vulcu/opossum/docs/images/Board-to-Board_Wiring.jpg

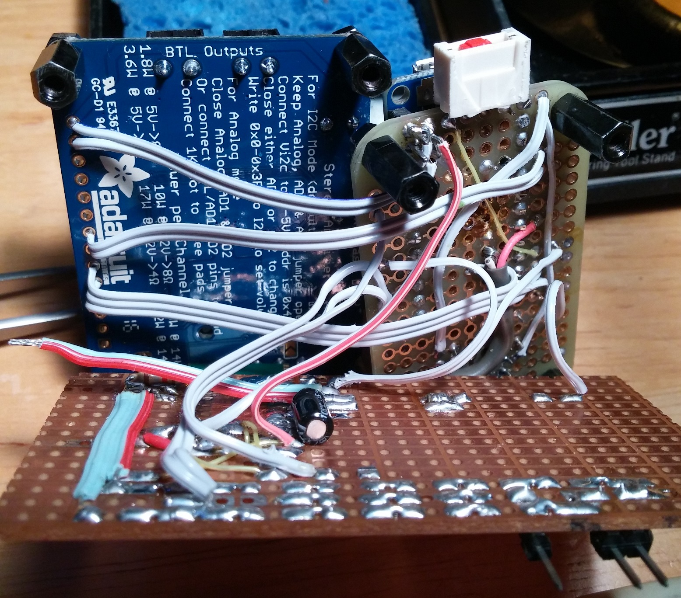
docs/images/Board-to-Board_Wiring.jpg
