vulcu/opossum/docs/images/Opossum_Bluetooth_Amplifier.jpeg

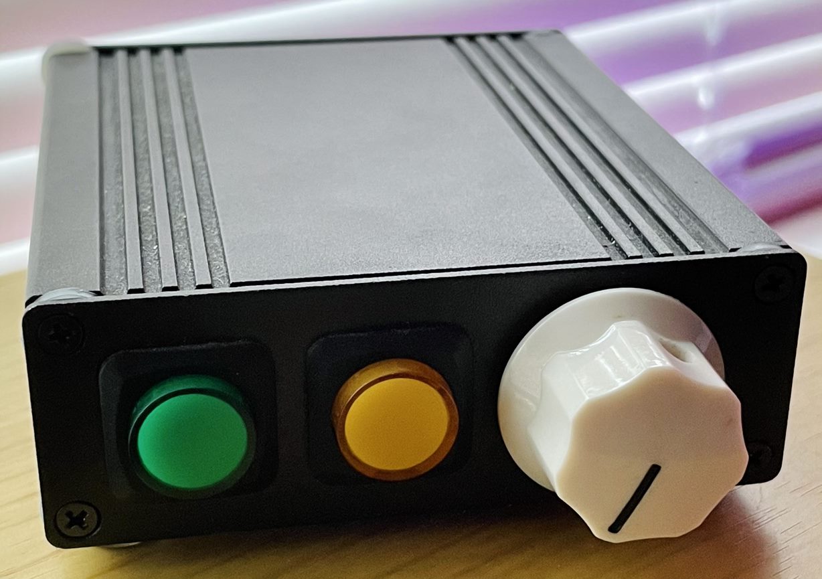
docs/images/Opossum_Bluetooth_Amplifier.jpeg
