vulcu/opossum/docs/schematics/Opossum_Bluetooth_Amplifier_(RevA5).pdf

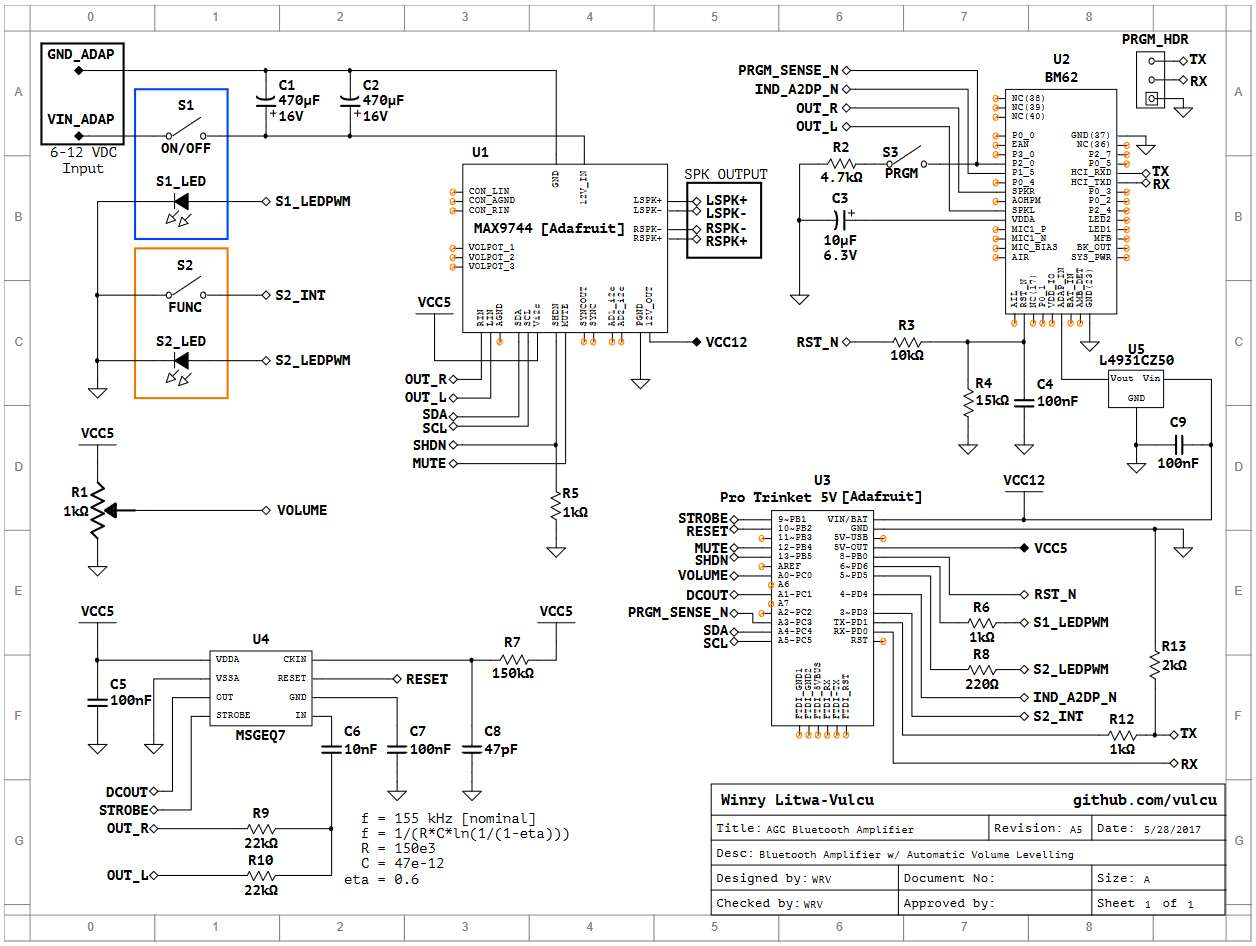
[picture p3: page 1]
