vulcu/opossum/docs/images/BM62_and_L4931CZ50.jpg

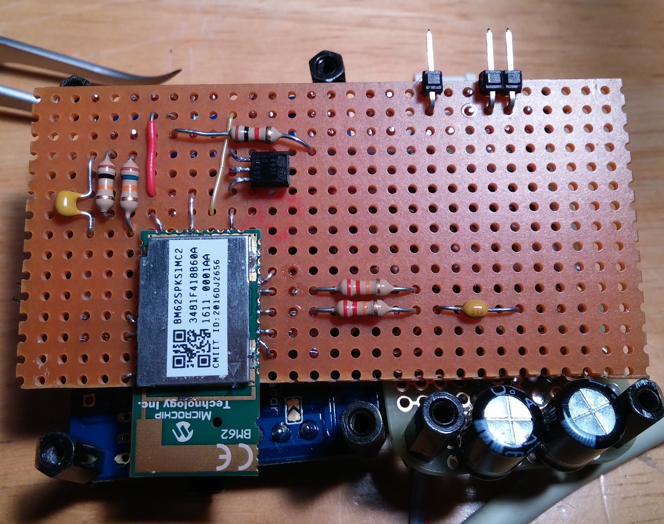
docs/images/BM62_and_L4931CZ50.jpg
