vulcu/opossum/docs/images/Pro_Trinket_MSGEQ7_and_MAX9744.jpg

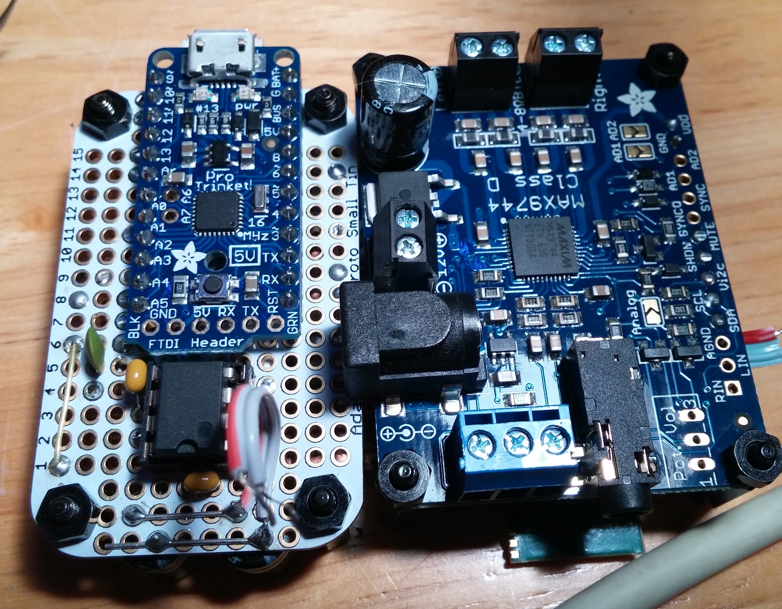
docs/images/Pro_Trinket_MSGEQ7_and_MAX9744.jpg
