vulcu/opossum/opossum/MAX9744.cpp

/*
 * MAX9744.cpp - Maxim MAX9744 Class-D Amplifier driver for Arduino
 * Copyright (c) 2017 Winry R. Litwa-Vulcu. All rights reserved.
 *
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
 * You should have received a copy of the GNU General Public License
 * along with this program.  If not, see <https://www.gnu.org/licenses/>.
 */

#include "MAX9744.h"

// MAX9744 amplifier gain levels (dB), stored as milli-Bells 
// (1/100 of a dB) to allow PROGMEM storage as an int type
const int16_t MAX9744::MAX9744Gain_milliBels[64] PROGMEM = 
{
  -10950,  -9290,   -9030,   -8680,
  -8430,   -8080,   -7830,   -7470,
  -7220,   -6870,   -6620,   -6270,
  -6020,   -5670,   -5420,   -5060,
  -4810,   -4560,   -4370,   -4210,
  -3960,   -3760,   -3600,   -3340,
  -3150,   -2980,   -2720,   -2520,
  -2350,   -2160,   -1970,   -1750,
  -1640,   -1540,   -1440,   -1310,
  -1200,   -1090,   -990,    -890,
  -710,    -600,    -500,    -340,
  -190,    -50,      50,      120,
   160,     200,     240,     290,
   340,     390,     440,     490,
   540,     590,     650,     700,
   760,     820,     880,     950
};

// class constructor for MAX9744 amplifier object
MAX9744::MAX9744(uint8_t i2c_addr, uint8_t mute_p, uint8_t shutdown_n, TwoWire* wire) :
  invert_mute(false) {
  this->i2c_addr = i2c_addr;
  this->mute_p = mute_p;
  this->shutdown_n = shutdown_n;
  this->wire = wire;
}

// initialize the MAX9744 and GPIO signals
void MAX9744::init(void) {
  pinMode(mute_p, OUTPUT);
  pinMode(shutdown_n, OUTPUT);

  // mute the MAX9744 then take it out of shutdown
  mute();
  enable();
}

// enable the MAX9744 by taking it out of shutdown (HIGH)
void MAX9744::enable(void) {
  digitalWrite(shutdown_n, HIGH);
}

// invert the mute signal (needed for use with Adafruit MAX9744 board)
void MAX9744::invertMuteLogic(const bool invert_mute) {
  this->invert_mute = invert_mute;
}

// mute the MAX9744 amplifier via the MUTE pin
void MAX9744::mute(void) {
  // if the mute signal is inverted then set LOW to mute
  if (invert_mute) {
    digitalWrite(mute_p, LOW);
  }
  else {
    digitalWrite(mute_p, HIGH);
  }
}

// disable the MAX9744 via the GPIO shutdown signal
void MAX9744::shutdown(void) {
  digitalWrite(shutdown_n, LOW);
}

// unmute the MAX9744 amplifier via the MUTE pin
void MAX9744::unmute(void) {
  // if the mute signal is inverted then set HIGH to unmute
  if (invert_mute) {
    digitalWrite(mute_p, HIGH);
  }
  else {
    digitalWrite(mute_p, LOW);
  }
}

// set the amplifier volume to a value between 0 [min] and 63 [max]
void MAX9744::volume(const uint8_t value) {
  // if the value is less than 64 and two-wire is configured
  if ((value < 64) & (TWCR != 0x00)) {
    wire->beginTransmission(i2c_addr);
      wire->write(value);
    wire->endTransmission();
  }
}

// return the dB gain values correllating amplifier volume settings
inline int16_t MAX9744::getGainAtVolumeIndex(const uint8_t index) {
  return pgm_read_word(&(MAX9744Gain_milliBels[index]));
}
