vulcu/opossum/(commit log)

2021-03-19 Update parameters.h
    added SERIAL_BUFFER_SIZE and ERROR_MSG_BUFFER_SIZE in the event that 'error.h' does get utilized
    [parameters.h]
2021-03-19 Update Opossum.ino
    moved MAX9744GainLevels init to 'drivers.h'
2021-03-19 Update Opossum.ino
    moved BM62 UART inits to 'drivers.h'
2021-03-19 Update Opossum.ino
    moved LED brightness values over to 'parameters.h'
2021-03-19 Update Opossum.ino
    moved BM62_isProgramMode def over to 'drivers.h'
2021-03-19 Update Opossum.ino
    moved `MSGEQ7_read` and `MSGEQ7_mean` definitions over to 'drivers.h'
2021-03-19 Update Opossum.ino
    serial debug console now outputs `volumeRange` at index 2 and 3 of Serial.print output array
2021-03-19 Update Opossum.ino
    moved `BM62_checksum` definition over to 'drivers.h'
2021-03-19 moved code from main *.ino file to header files for better code legibility and easier maintenance
    a lot of hardware control and I/O related function definitions and constants were moved over to 'drivers.h' and 'parameters.h'
2021-03-20 Create BM62 driver class
    refactor BM62 driver code from 'driver.h' to a separate class defined in 'BM62.h'
2021-03-20 remove old driver code
    comment out old BM62 driver code and configure to use new BM62 driver only
2021-03-20 Update BM62.h
    fix media play control input arguments from `uint8_t` for `void`
    [BM62.h]
2021-03-20 refactor UART write process to remove redundant code
2021-03-20 remove old BM62 driver from 'drivers.h'
2021-03-20 update BM62 driver
    * removed `low`, `high`, and `read` methods
    * instances of `low` and `high` replaced with built-in digitalWrite
    * added `isConnected` method to return active A2DP connection state (`false` if no connection available)
    * added `reset` method to set active state of `RST_N` reset pin (setting this `true` will put the BM62 into reset)
    [BM62.h, Opossum.ino]
2021-03-20 update main code to use to new 'MSGEQ7.h' driver
2021-03-20 comment out old driver
2021-03-21 remove old commented driver code
2021-03-21 change BM62 reset method from `reset(true/false)` to `enable()/reset()`
    [BM62.h]
2021-03-21 Update BM62.h
    fix typo when calling isConnected()
    [BM62.h]
2021-03-21 create 'MAX9744.h', delete 'drivers.h'
    initial commit of MAX9744 driver, nonfunctional but not removing any functionality either. Copied directly from 'drivers.h'.
2021-03-21 removed reference to deleted 'drivers.h' header in main file
2021-03-21 modify BM62 and MSGEQ7
    * Drivers now require pin numbers on init instead of using 'parameters.h' macros. Simplifies the way HW definitions are provided to the driver and greatly improves portability of code
    * restructured driver classes to put public methods first, followed by private methods
2021-03-21 fix enable()/reset() logic inversion in BM62 driver
    [BM62.h]
2021-03-21 Update Opossum.ino
    remove 'drivers.h' include
2021-03-22 update driver define name to better match other code I've seen? don't know what's good practice here
2021-03-22 added in probably all the methods needed, although driver not presently working
2021-03-22 Update MSGEQ7.h
    modified `strobe` and `reset` to `strobe_p` and `reset_p`
    [MSGEQ7.h]
2021-03-22 Update MAX9744.h
    fixed mute/shutdown control issues; driver is now working although there is some loud RF noise at startup not previously present
    [MAX9744.h]
2021-03-23 Fixed power-on noise (previous commit) and PROGMEM directive being ignored for gain table
    moved PROGMEM declaration of MAX9744 gain table outside of class as PROGMEM directive was being ignored. Might not be possible to use this macro from within a class?
    [MAX9744.h]
2021-03-23 Update Opossum.ino
    `OUTPUT` macro mistakenly used in place of `DC_OUT`
    [Opossum.ino]
2021-03-24 pass a pointer to drivers for TwoWire and HardwareSerial classes instead of driver instancing the hardware
2021-03-26 rename 'pushbutton.h' to 'ledbutton.h'
    and as LED as a class callable by BUTTON
2021-03-27 create LED and BUTTON classes, extend BUTTON class using LEDBUTTON
    * renamed 'ledbutton.h' to 'userinterface.h'
    * modified `S2_PWM` and `S1_PWM` type from `uint8_t` to `int8_t`
2021-03-27 start implementing SW2 interrupt service routing and button functionality
2021-03-27 completed rough framework of S2 interrupt routine
    not working yet :-1:
    [Opossum.ino, parameters.h]
2021-03-28 change SW2 to `inputPullup` and rename `buttonPressCount` to `buttonStateCount`
2021-03-28 fixed LED dereferencing bug in 'userinterface.h'
    [Opossum.ino, parameters.h]
2021-03-28 SW2 interrupts finally working... sort of :grimacing:
2021-03-29 add LED init to LEDBUTTON init, define S2 interrupt vector in 'parameters.h'
2021-03-29 Update userinterface.h
    override LEDBUTTON `enableInputPullup()` and `disableInputPullup()` methods to also initialize the LED
2021-04-03 modified `Button` and `LED_Button` class name capitalization (no longer all-caps)
    [Opossum.ino]
2021-04-03 Update Opossum.ino
    update main file to include latest changes to button interrupt handling
2021-04-03 ditched Timer1, button interrupts finally working as intended
2021-04-03 Update Opossum.ino
    brought debug build changes over, S2 button is working as expected
2021-04-10 use defined reset cycle wait time instead of a hardcoded value
    [BM62.h]
2021-04-10 add additional BM62 UART commands for EQ, pairing, and information
2021-04-10 split 'userinterface.h' out into 'ledbutton.h' and 'ledbutton.cpp'
2021-04-10 modify `#include` statements to reflect renaming from 'userinterface' to 'ledbutton'
2021-04-10 remove unused variable and define MSGEQ7 read pin input pullup in 'opossum.h'
2021-04-10 modified 'ledbutton.h' comments for clarity
2021-04-10 Update ledbutton.cpp
    fixed comment to correctly describe function
    [ledbutton.cpp]
2021-04-11 replace `BM62::writeMediaCommand` with `BM62::writeSerialCommand`
    [BM62.cpp, BM62.h]
2021-04-11 Update BM62.cpp
    comment out `GetDeviceInformation` and `GetElementAttributes` command data as these won't be implemented right now, but leave the comments because I don't want to lose this information later
    [BM62.cpp]
2021-04-11 fix spurious button trigger at power-on
    also fix missing call to `Audiomath` static method
    [Opossum.ino]
2021-04-17 modify BM62 driver to better conceptualize serial commands
    updating the driver in this way allows for an easier time adding new commands and also meshes much better with the way the datasheet/part documentation conceptualizes the serial uart commands
2021-04-17 fix 'not writing entire serial command' bug
    [BM62.cpp]
2021-04-17 update main file to start adding in button press functionality
    * added 'enter pairing mode' and 'enable/disable EQ' for now because those are the easiest ones
    * added some debug code around this but like the other `DEBUG` code blocks it's inside preprocessor directives
2021-04-17 fix 'led not initialized correctly during BT pairing'
    also added slight clarification to comment about delay to avoid missing UART reads b/c although it helps it's not guaranteed to work. this may be a bug or it may be a "won't fix" kind of bug
    [Opossum.ino]
2021-04-18 add features to BM62 driver
    * add play/pause media playback toggle function (pauses if playing, plays if paused)
    * added additional EQ presets to `setEqualizerPreset` method and `EQ_preset` enum
    * upgraded `...Next_Track` and `...Prev_Track` commands from deprecated syntax (formerly MMI actions, now Music Control actions)
2021-04-18 remove debug preprocessor directive for tracking button presses
2021-04-18 remove remaining debug button tracking code
2021-04-18 improve clarity of BM62 driver debug output
2021-04-19 add `convertVolumeToGain` method and store gain values in milli-Bels instead of centi-Bels
2021-04-20 add `convertVolumeToGain` method to MAX9744 driver
    * change MAX9744 gain level PROGMEM storage from centi-Bels to milli-bels
    * add MATLAB for-loop code that should be rewritable to C and provide all of the real available amplifier gain levels that fall within a given dB range
2021-05-01 move `convertVolumeToGain` method out of MAX9744 driver and convert to a static `Audiomath` method
    also add `getGainAtVolumeIndex` static method to MAX9744 driver
2021-05-02 update `MSGEQ7::read` and `MSGEQ7::mean` methods to correctly utilize size_t type
    [MSGEQ7.cpp, Opossum.ino]
2021-05-02 update `Audiomath::mapVolumeToBoundedRange`, still bugs to fix
    [Opossum.ino, audiomath.cpp, audiomath.h]
2021-05-03 fix numerous `mapVolumeToBoundedRange` bugs
    [Opossum.ino, audiomath.cpp]
2021-05-04 add wdt ISR to shut down and reboot a locked up system
    [Opossum.ino, audiomath.cpp]
2021-05-05 move button interrupt check outside of audio read interval condition
2021-05-05 add/modify location of `wdt_reset()` calls to guard against unintended resets
    [Opossum.ino]
2021-05-05 move audio level read updates to last in main loop (swap order with vol ctrl read) and begin adding `feature_AGC_mode`
    [Opossum.ino]
2021-06-25 created Audiomath::getVolumeMapIndx static method prototype
2021-06-27 bugfix for `spectrum.mean90` not being called with the correct array size
    also fixed `dBLevels` array to initialize at correct size
    [Opossum.ino, audiomath.cpp]
2021-10-02 modify static variable names to prevent namespace collisions
    [audiomath.cpp]
2021-10-02 modify static class global variable names to prevent namespace collision
    [audiomath.cpp]
2021-10-02 bugfix for `vm_index` minima never being reached
    [audiomath.cpp]
2021-10-02 add AGC control of SW2 LED brightness to indicate adjustment direction
2021-10-03 increase `MSGEQ7_ZERO_SIGNAL_LEVEL` by 33% to account for increased noise floor inside enclosure
    [opossum.h]
2021-10-11 add check of EEPROM at power-on and update of EEPROM when AGC or EQ state is toggled
2021-10-11 EEPROM register init state monitoring, plus temporary reset-to-default code which must be manually removed after running once!
    [Opossum.ino]
2021-10-12 fix for known EEPROM initialization bug, improves the way init is handled and tracked
    [Opossum.ino]
2021-10-12 added schematics and images of project
2021-10-13 modify AGC algorithm to avoid volume jumps
    [audiomath.cpp]
2021-10-13 modify AGC LED to indicate changes in output volume not volume map
